chvvkumar/allsky-asi676-focuser/images/picture.jpg

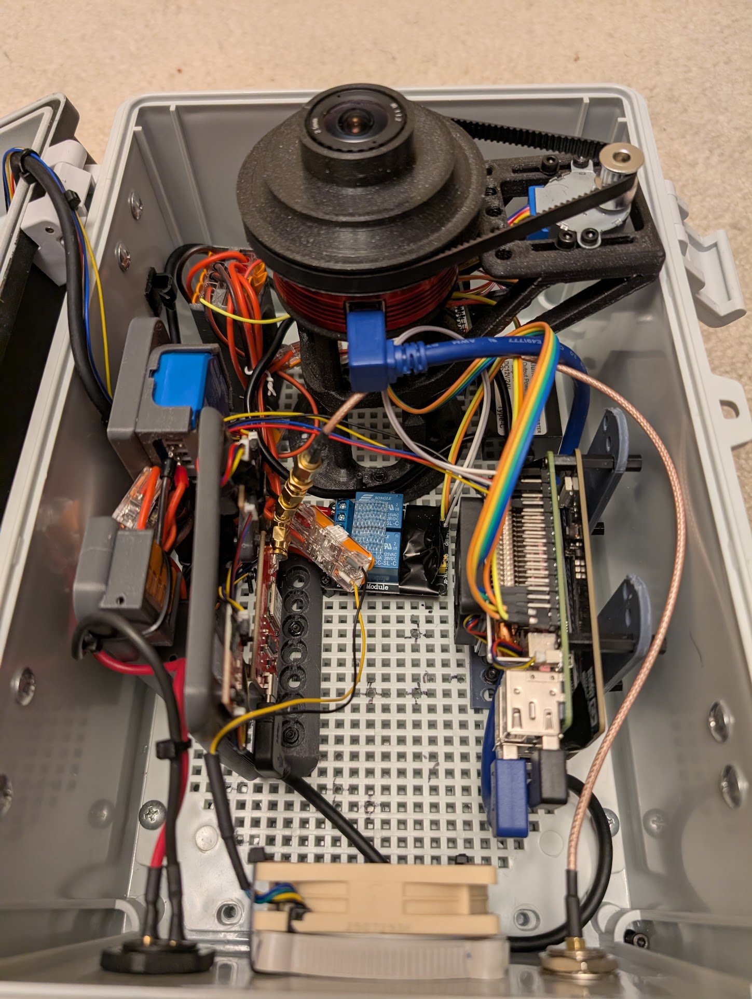
images/picture.jpg
