chvvkumar/allsky-asi676-focuser/(commit log)

2026-01-20 Add web interface for lens control, uninstallation script, and ZWO camera streaming functionality
    - Created `index.html` for the lens controller web interface with responsive design and control features.
    - Added `uninstall.sh` script to facilitate the removal of services and virtual environments.
    - Implemented `zwo.py` for handling ZWO camera streaming, including settings management and error handling.
    [Config.h, Logger.h, StepperMotor.h, app.py, stepper_motor.ino, zwo.py]
2026-01-20 Enhance README with YouTube demo link, updated Table of Contents, and 3D printed parts information
2026-01-20 Add circuit diagram
2026-10-14 Fix streamer stall on bad resolution; resize instead of crop
    set_roi raised after stop_video_capture and capture was never restarted,
    so every frame timed out. Capture now restarts in a finally block and a
    rejected size is not retried every frame.
    Resolution now selects a hardware bin over the full sensor field and the
    frame is fit-resized to the requested size instead of cropping an ROI.
    RGB24 output so binned frames keep color. Capture errors yield an error
    frame so disconnected clients exit the generator. Replace the 3840x2160
    option with the ASI676MC full frame 3552x3552.
2026-10-14 Track camera bin globally so any stream rebins on mismatch
2026-10-14 Add focus metric endpoint to camera streamer
    GET /focus_metric scores an ROI of the latest captured frame: Laplacian
    variance for day, inverse median star radius for night. Serves the
    autofocus loop in app.py.
2026-10-14 Add autofocus sweep controller to motor service
    Single ascending sweep around the current position, scores each point
    via the camera service's /focus_metric, parabola-fits the best three,
    and approaches the result from below to take up backlash. Exposed as
    /api/autofocus/start, /stop, /status.
2026-10-14 Harden autofocus: busy and limit checks, abort stays put
    Reject a start while the motor is moving or when the sweep would exceed
    max_limit, raise if a move settles at the wrong position, keep running
    set until the return move is issued, and leave the motor in place on
    abort since /api/stop is an emergency stop. Camera fetch timeout now
    covers long night exposures.
2026-10-14 Discard in-flight frame before scoring; keep AF status polling alive
    The first frame after a move was exposing during the move, biasing
    night scores toward the previous position. /focus_metric now skips one
    frame. Chart marks the fitted best position even between samples, and
    status polling tolerates three failed fetches.
2026-10-14 Measure night HFR in a fixed aperture; expose settle time; flag edge-of-range best
    The previous night metric averaged radius only over pixels above the
    detection threshold, so a defocused, dimmer star measured smaller and
    the curve went the wrong way. Now each star's half-flux radius is
    measured in a 31x31 window with local background subtracted, which rises
    monotonically with blur. Web UI gains a SETTLE (ms) field wired to
    settle_ms, chart shows axis extents, and a best score on the first or
    last sweep point is called out in the status message.
